garrettsworkshop/RAM128/Documentation/RAM128.4208B-Schematic.pdf

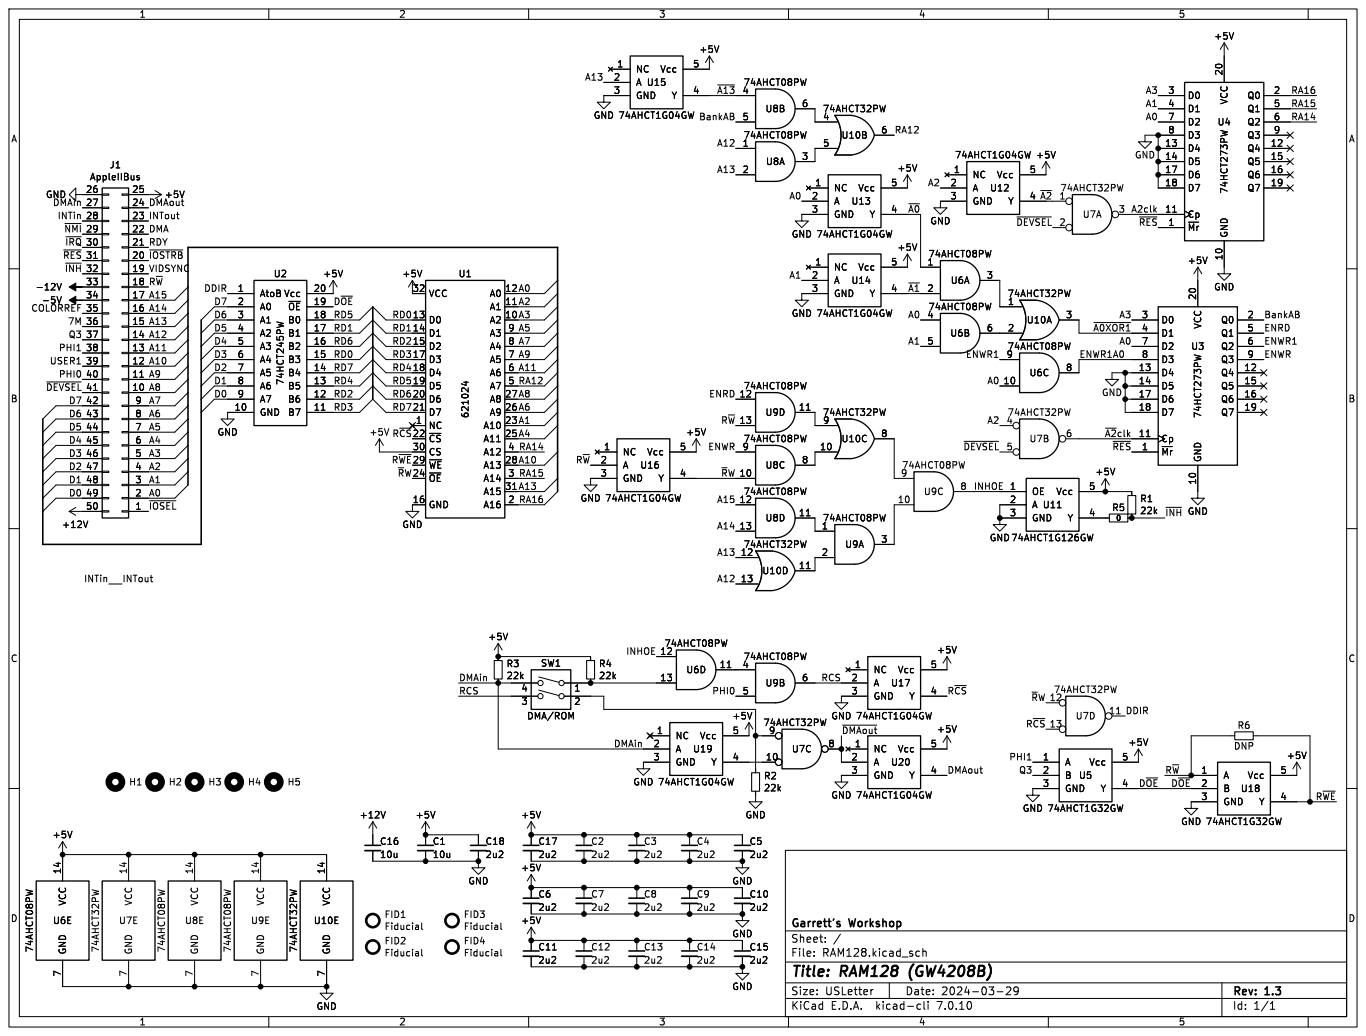
[picture p1: page 1]

Id: 1/1 Title: RAM128 (GW4208B) File: RAM128.kicad_sch Sheet: / Garrett's Workshop
