garrettsworkshop/RAM128/Documentation/RAM128.4208B-Placement.pdf

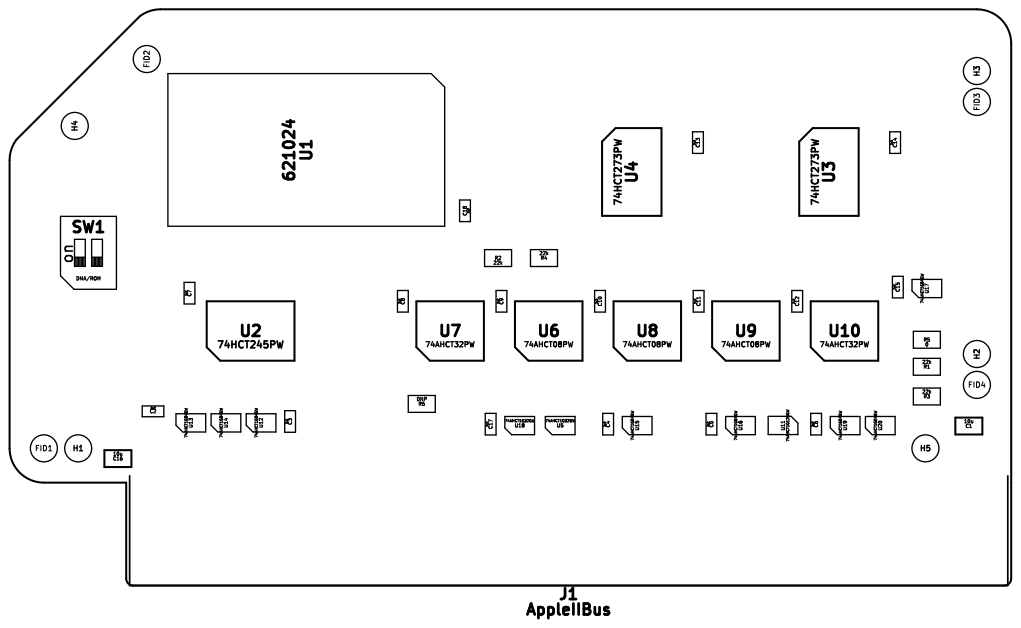
[picture p2: page 1]
