garrettsworkshop/RAM128/RAM128.kicad_pcb

## KiCad design RAM128.kicad_pcb (2024-03-29)

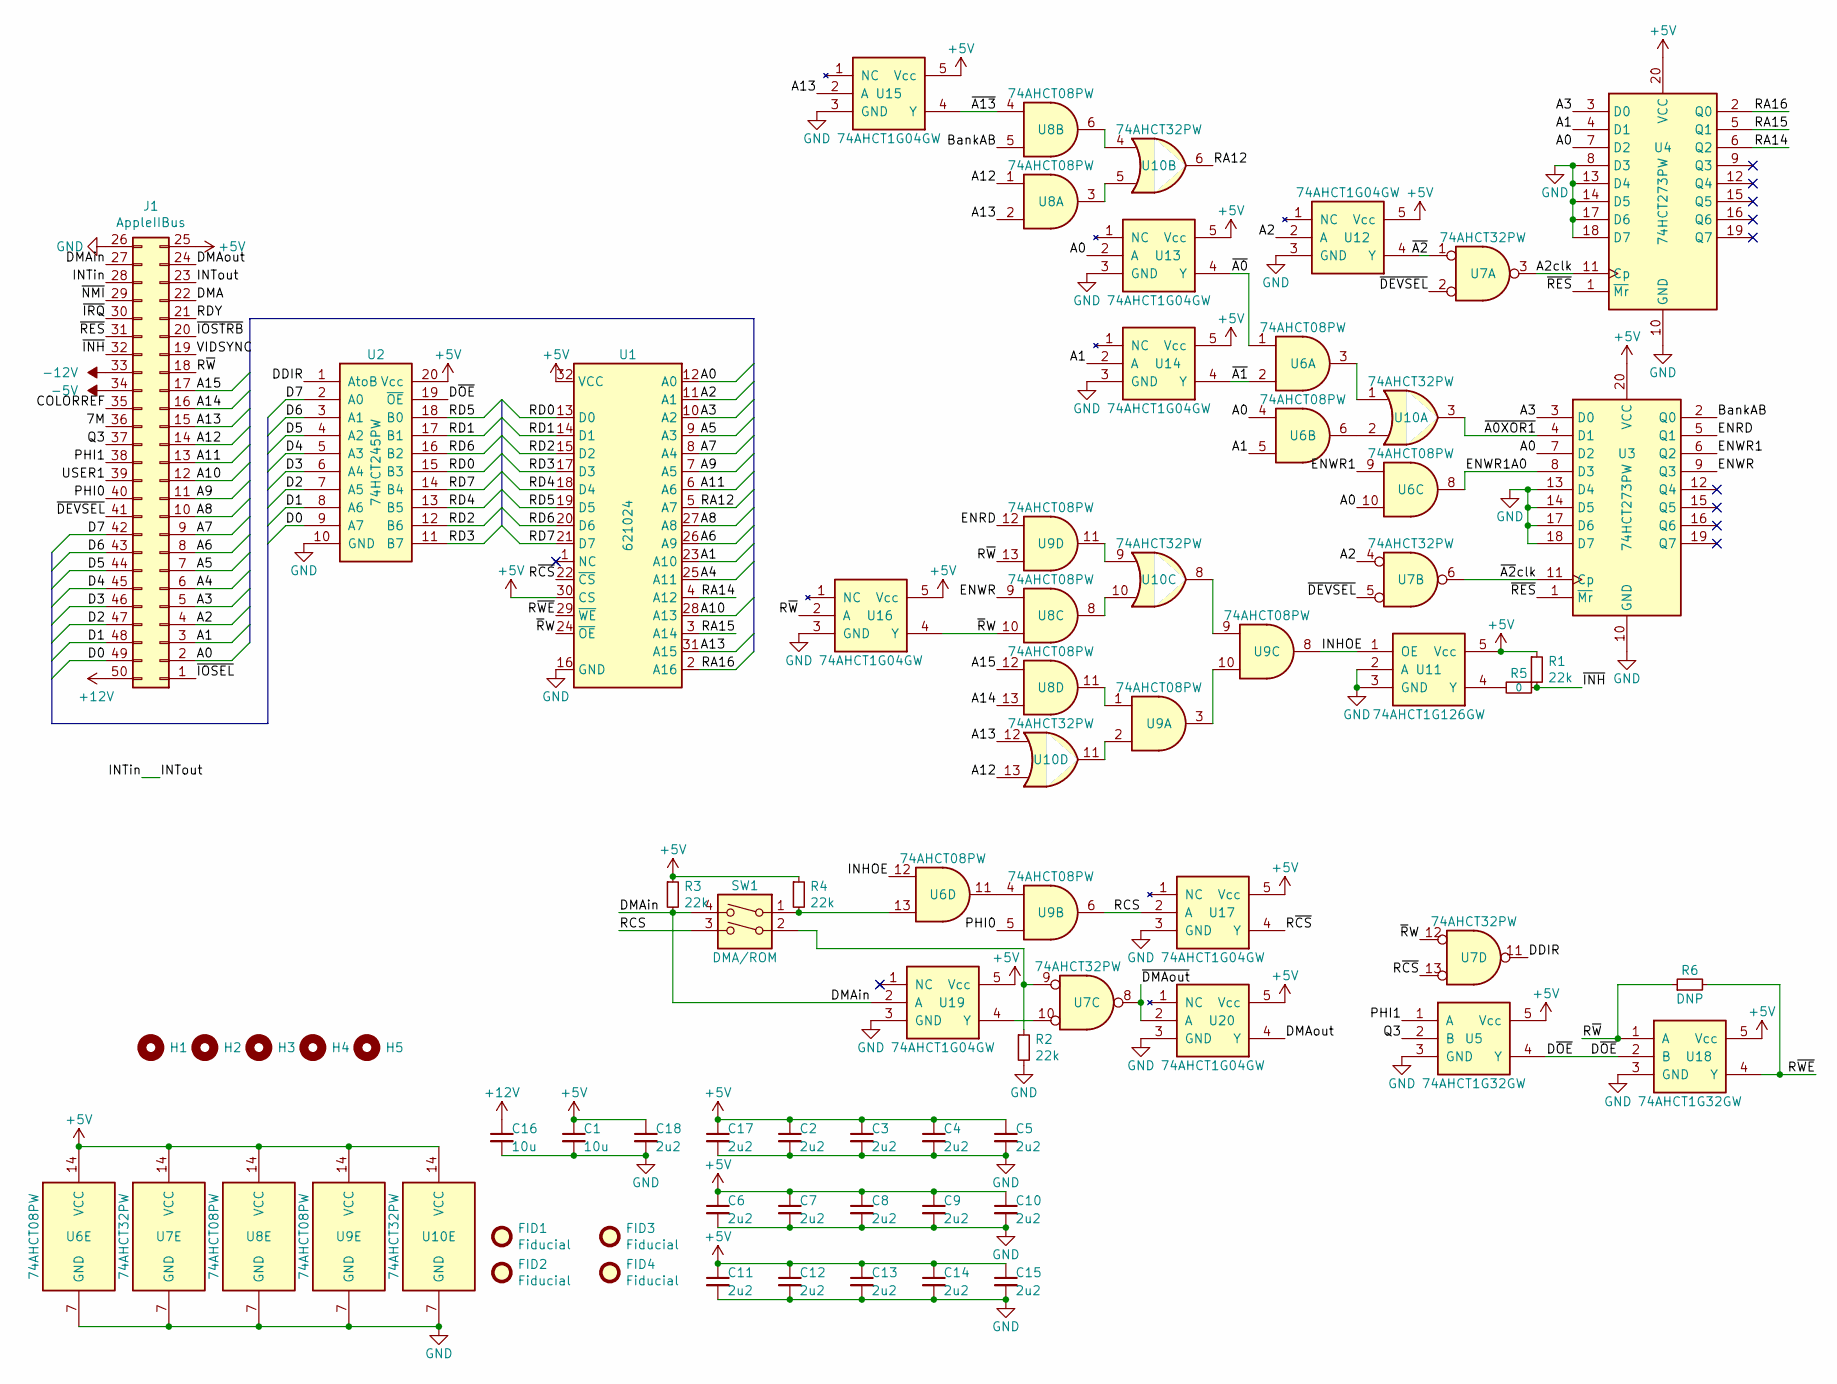
[picture p3: schematic RAM128.kicad_sch, RAM128 (GW4208B)]

Parts:
C1, C16: 10u; C_0805; LCSC Part C15850
C2, C3, C4, C5, C6, C7, C8, C9, C10, C11, C12, C13, C14, C15, C17, C18: 2u2; C_0603; LCSC Part C23630
FID1, FID2, FID3, FID4: Fiducial
H1, H2, H3, H4, H5: PasteHole_1.152mm_NPTH
J1: AppleIIBus; AppleIIBus_Edge
R1, R2, R3, R4: 22k; R_0805; LCSC Part C17560
R5: 0; R_0805; LCSC Part C17477
R6: DNP; R_0805
SW1: DMA/ROM; SW_DIP_SPSTx02_Slide_DSHP02TS_P1.27mm; LCSC Part C319052
U1: 621024; SOP-32_450mil; LCSC Part C397875
U2: 74HCT245PW; TSSOP-20_4.4x6.5mm_P0.65mm; LCSC Part C5980
U3, U4: 74HCT273PW; TSSOP-20_4.4x6.5mm_P0.65mm; LCSC Part C5983
U5, U18: 74AHCT1G32GW; SOT-353; LCSC Part C554582
U6, U8, U9: 74AHCT08PW; TSSOP-14_4.4x5mm_P0.65mm; LCSC Part C155175
U7, U10: 74AHCT32PW; TSSOP-14_4.4x5mm_P0.65mm; LCSC Part C129435
U11: 74AHCT1G126GW; SOT-353; LCSC Part C150723
U12, U13, U14, U15, U16, U17, U19, U20: 74AHCT1G04GW; SOT-353; LCSC Part C148199

Connections:
+5V: C1.1, C2.1, C3.1, C4.1, C5.1, C6.1, C7.1, C8.1, C9.1, C10.1, C11.1, C12.1, C13.1, C14.1, C15.1, C17.1, C18.1, J1.25, R1.1, R3.1, R4.1, U1.30 (CS), U1.32 (VCC), U2.20 (Vcc), U3.20 (VCC), U4.20 (VCC), U5.5 (Vcc), U6.14 (VCC), U7.14 (VCC), U8.14 (VCC), U9.14 (VCC), U10.14 (VCC), U11.5 (Vcc), U12.5 (Vcc), U13.5 (Vcc), U14.5 (Vcc), U15.5 (Vcc), U16.5 (Vcc), U17.5 (Vcc), U18.5 (Vcc), U19.5 (Vcc), U20.5 (Vcc)
+12V: C16.1, J1.50
-5V: J1.34
-12V: J1.33
/7M: J1.36
/A0: J1.2, U1.12 (A0), U3.7 (D2), U4.7 (D2), U6.4, U6.10, U13.2 (A)
/A1: J1.3, U1.23 (A10), U4.4 (D1), U6.5, U14.2 (A)
/A2: J1.4, U1.11 (A1), U7.4, U12.2 (A)
/A2clk: U4.11 (Cp), U7.3
/A3: J1.5, U1.10 (A2), U3.3 (D0), U4.3 (D0)
/A4: J1.6, U1.25 (A11)
/A5: J1.7, U1.9 (A3)
/A6: J1.8, U1.26 (A9)
/A7: J1.9, U1.8 (A4)
/A8: J1.10, U1.27 (A8)
/A9: J1.11, U1.7 (A5)
/A10: J1.12, U1.28 (A13)
/A11: J1.13, U1.6 (A6)
/A12: J1.14, U8.1, U10.13
/A13: J1.15, U1.31 (A15), U8.2, U10.12, U15.2 (A)
/A14: J1.16, U8.13
/A15: J1.17, U8.12
/BankAB: U3.2 (Q0), U8.5
/COLORREF: J1.35
/D0: J1.49, U2.9 (A7)
/D1: J1.48, U2.8 (A6)
/D2: J1.47, U2.7 (A5)
/D3: J1.46, U2.6 (A4)
/D4: J1.45, U2.5 (A3)
/D5: J1.44, U2.4 (A2)
/D6: J1.43, U2.3 (A1)
/D7: J1.42, U2.2 (A0)
/DDIR: U2.1 (AtoB), U7.11
/DMA: J1.22
/DMAin: J1.27, R3.2, SW1.4, U19.2 (A)
/DMAout: J1.24, U20.4 (Y)
/D~OE: U2.19 (~OE), U5.4 (Y), U18.2 (B)
/ENRD: U3.5 (Q1), U9.12
/ENWR: U3.9 (Q3), U8.9
/ENWR1: U3.6 (Q2), U6.9
/ENWR1A0: U3.8 (D3), U6.8
/INHOE: U6.12, U9.8, U11.1 (OE)
/INTin: J1.23, J1.28
/PHI0: J1.40, U9.5
/PHI1: J1.38, U5.1 (A)
/Q3: J1.37, U5.2 (B)
/RA12: U1.5 (A7), U10.6
/RA14: U1.4 (A12), U4.6 (Q2)
/RA15: U1.3 (A14), U4.5 (Q1)
/RA16: U1.2 (A16), U4.2 (Q0)
/RCS: SW1.3, U9.6, U17.2 (A)
/RD0: U1.13 (D0), U2.15 (B3)
/RD1: U1.14 (D1), U2.17 (B1)
/RD2: U1.15 (D2), U2.12 (B6)
/RD3: U1.17 (D3), U2.11 (B7)
/RD4: U1.18 (D4), U2.13 (B5)
/RD5: U1.19 (D5), U2.18 (B0)
/RD6: U1.20 (D6), U2.16 (B2)
/RD7: U1.21 (D7), U2.14 (B4)
/RDY: J1.21
/R~CS: U1.22 (~CS), U7.13, U17.4 (Y)
/R~WE: R6.2, U1.29 (~WE), U18.4 (Y)
/R~W: J1.18, R6.1, U9.13, U16.2 (A), U18.1 (A)
/USER1: J1.39
/VIDSYNC: J1.19
/~A0XOR1: U3.4 (D1), U10.3
/~A0: U6.1, U13.4 (Y)
/~A1: U6.2, U14.4 (Y)
/~A2: U7.1, U12.4 (Y)
/~A2clk: U3.11 (Cp), U7.6
/~A13: U8.4, U15.4 (Y)
/~DEVSEL: J1.41, U7.2, U7.5
/~DMAout: U7.8, U20.2 (A)
/~INH: J1.32, R1.2, R5.1
/~IOSEL: J1.1
/~IOSTRB: J1.20
/~IRQ: J1.30
/~NMI: J1.29
/~RES: J1.31, U3.1 (~Mr), U4.1 (~Mr)
/~RW: U1.24 (~OE), U7.12, U8.10, U16.4 (Y)
GND: C1.2, C2.2, C3.2, C4.2, C5.2, C6.2, C7.2, C8.2, C9.2, C10.2, C11.2, C12.2, C13.2, C14.2, C15.2, C16.2, C17.2, C18.2, J1.26, R2.2, U1.16 (GND), U2.10 (GND), U3.10 (GND), U3.13 (D4), U3.14 (D5), U3.17 (D6), U3.18 (D7), U4.8 (D3), U4.10 (GND), U4.13 (D4), U4.14 (D5), U4.17 (D6), U4.18 (D7), U5.3 (GND), U6.7 (GND), U7.7 (GND), U8.7 (GND), U9.7 (GND), U10.7 (GND), U11.2 (A), U11.3 (GND), U12.3 (GND), U13.3 (GND), U14.3 (GND), U15.3 (GND), U16.3 (GND), U17.3 (GND), U18.3 (GND), U19.3 (GND), U20.3 (GND)
unnamed: R2.1, SW1.2, U7.9
unnamed: R4.2, SW1.1, U6.13
unnamed: U6.11, U9.4
unnamed: U8.11, U9.1
unnamed: U9.3, U9.10
unnamed: U6.3, U10.1
unnamed: U6.6, U10.2
unnamed: U8.6, U10.4
unnamed: U8.3, U10.5
unnamed: U9.9, U10.8
unnamed: U9.11, U10.9
unnamed: U8.8, U10.10
unnamed: U9.2, U10.11
unnamed: R5.2, U11.4 (Y)
unnamed: U7.10, U19.4 (Y)

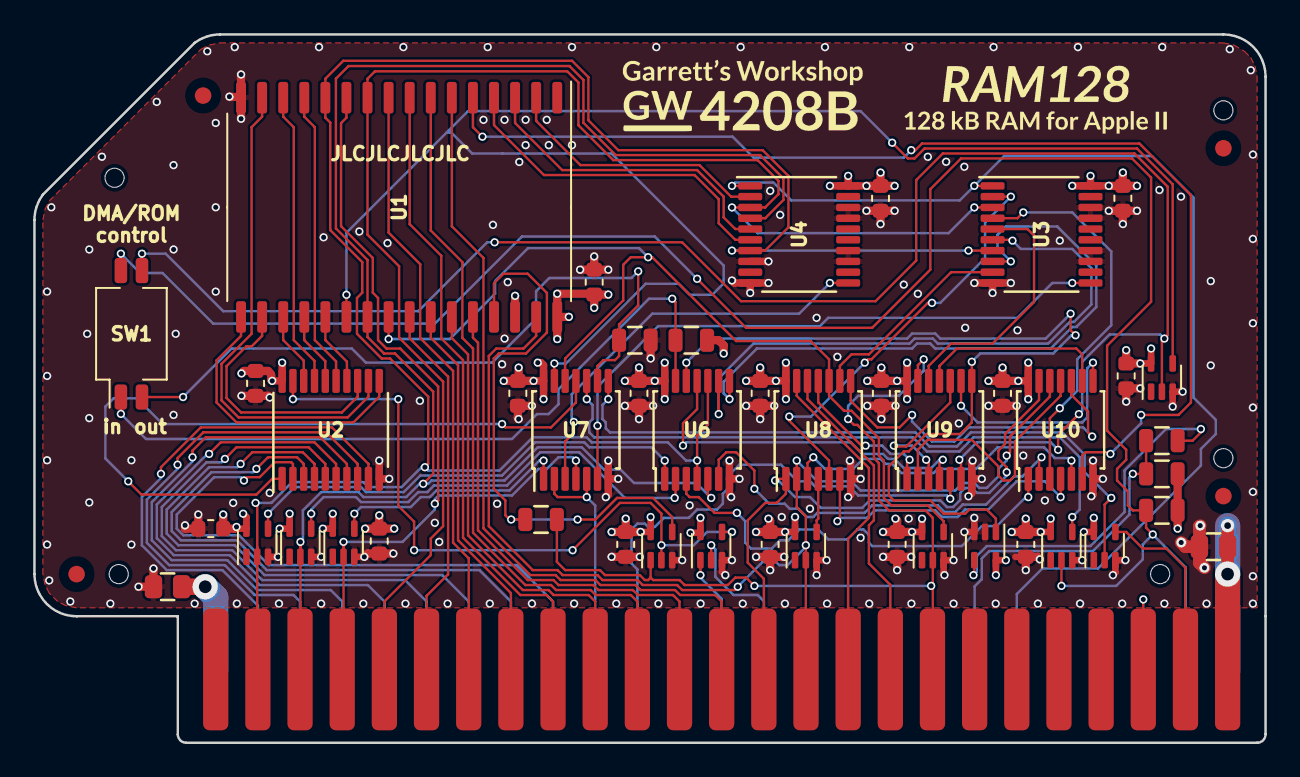
[picture p4: board RAM128.kicad_pcb from above]

Board: 4 copper layers, 74.2 x 42.7 mm, 55 parts (0 on the bottom side), 84 nets.
