garrettsworkshop/RAM128/(commit log)

2020-07-25 Add GW4208A files
    [Voyager128-B_Cu.gbl, Voyager128-B_Mask.gbs, Voyager128-B_SilkS.gbo, Voyager128-Edge_Cuts.gm1, Voyager128-F_Cu.gtl, Voyager128-F_Mask.gts, Voyager128-F_Paste.gtp, Voyager128-F_SilkS.gto]
2020-09-10 Board done but ugly
    [Voyager128.kicad_pcb, Voyager128.sch]
2020-09-11 Routing done, needs made pretty
    [Voyager128-B_Cu.gbl, Voyager128-B_Mask.gbs, Voyager128-B_SilkS.gbo, Voyager128-Edge_Cuts.gm1, Voyager128-F_Cu.gtl, Voyager128-F_Mask.gts, Voyager128-F_Paste.gtp, Voyager128-F_SilkS.gto]
2020-09-12 Change file names, delete old pictures, documentation, and geber files
    [RAM128.kicad_pcb, RAM128.sch, Voyager128.kicad_pcb]
2020-09-12 Update docs
    [RAM128.kicad_pcb, RAM128.sch]
2020-09-20 More stitching
    [RAM128.kicad_pcb]
2020-09-29 Fixed clock bug
    [RAM128-BOM.csv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]
2020-10-14 DMA_OUT change
    [RAM128.kicad_pcb, RAM128.sch]
2020-10-22 done with little logic
    [RAM128.kicad_pcb, RAM128.sch]
2020-10-23 little logic done
    [RAM128.kicad_pcb, RAM128.sch]
2020-10-24 Revert "little logic done"
    This reverts commit a060165095faf621a659fc8f0bd54866ab46c410.
    [RAM128.kicad_pcb, RAM128.sch]
2020-10-24 Revert "done with little logic"
    This reverts commit e18c2f2ed5eeb331b091e4749a0e5c3a6d648d84.
    [RAM128.kicad_pcb, RAM128.sch]
2020-12-04 Good but ugly
    [RAM128-BOM.csv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]
2022-02-06 Migrate to KiCAD 6
    [RAM128.kicad_pcb, RAM128.kicad_sch, RAM128.sch]
2022-08-07 As submitted to JLC
    [RAM128-B_Cu.gbl, RAM128-B_Mask.gbs, RAM128-B_SilkS.gbo, RAM128-B_Silkscreen.gbo, RAM128-Edge_Cuts.gm1, RAM128-F_Cu.gtl, RAM128-F_Mask.gts, RAM128-F_Paste.gtp]
2023-01-02 Documentation update
    [RAM128.kicad_pcb]
2023-12-07 1.2 prototype as sent to JLC
    [RAM128-B_Cu.gbl, RAM128-B_Mask.gbs, RAM128-B_Silkscreen.gbo, RAM128-Edge_Cuts.gm1, RAM128-F_Cu.gtl, RAM128-F_Mask.gts, RAM128-F_Paste.gtp, RAM128-F_Silkscreen.gto]
2023-12-07 Update schematic and PCB version and revision date
    [RAM128-B_Cu.gbl, RAM128-B_Mask.gbs, RAM128-B_Silkscreen.gbo, RAM128-Edge_Cuts.gm1, RAM128-F_Cu.gtl, RAM128-F_Mask.gts, RAM128-F_Paste.gtp, RAM128-F_Silkscreen.gto]
2024-01-07 1.2 RC2
    [RAM128-BOM.csv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]
2024-01-31 1.2 RC3
    Moved 621024 bypass cap over--that's it
    [RAM128-B_Cu.gbl, RAM128-B_Mask.gbs, RAM128-B_Silkscreen.gbo, RAM128-Edge_Cuts.gm1, RAM128-F_Cu.gtl, RAM128-F_Mask.gts, RAM128-F_Paste.gtp, RAM128-F_Silkscreen.gto]
2024-02-01 1.2 RC4
    [RAM128-BOM.csv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]
2024-03-03 Update Makefile
    Delete old gerber zip file before rezipping
2024-03-03 Add BOM export and rebuild. No board changes
    [RAM128-BOM.csv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]
2024-03-03 Update BOM, no board changes
    [RAM128-BOM.csv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]
2024-03-18 Adopt 0.5mm via-to-via spacing
    [RAM128-B_Cu.gbl, RAM128-B_Mask.gbs, RAM128-B_Silkscreen.gbo, RAM128-Edge_Cuts.gm1, RAM128-F_Cu.gtl, RAM128-F_Mask.gts, RAM128-F_Paste.gtp, RAM128-F_Silkscreen.gto]
2024-03-29 RC 1.3
    [RAM128-B_Cu.gbl, RAM128-B_Mask.gbs, RAM128-B_Silkscreen.gbo, RAM128-Edge_Cuts.gm1, RAM128-F_Cu.gtl, RAM128-F_Mask.gts, RAM128-F_Paste.gtp, RAM128-F_Silkscreen.gto]
